likapateknoloji/kicad_libraries/likapa-3dmodels/ESP-WROOM-02.step

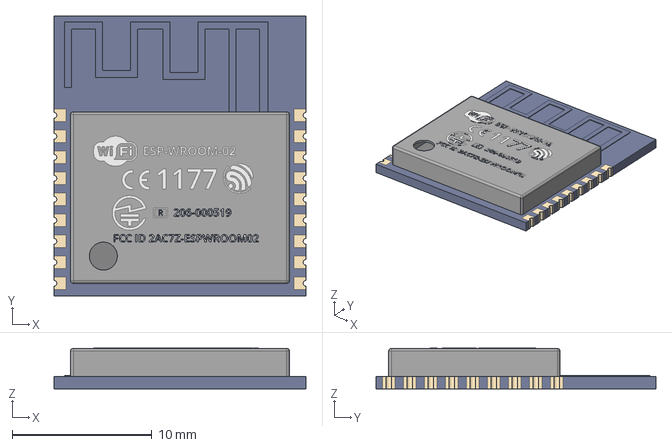
[picture p1: CAD file, 2023-02-28]
likapa-3dmodels/ESP-WROOM-02.step
18.0 x 20.0 x 2.93 mm
