likapateknoloji/kicad_libraries/likapa-3dmodels/TactileButton(6x3,5mm)_SMD.stp

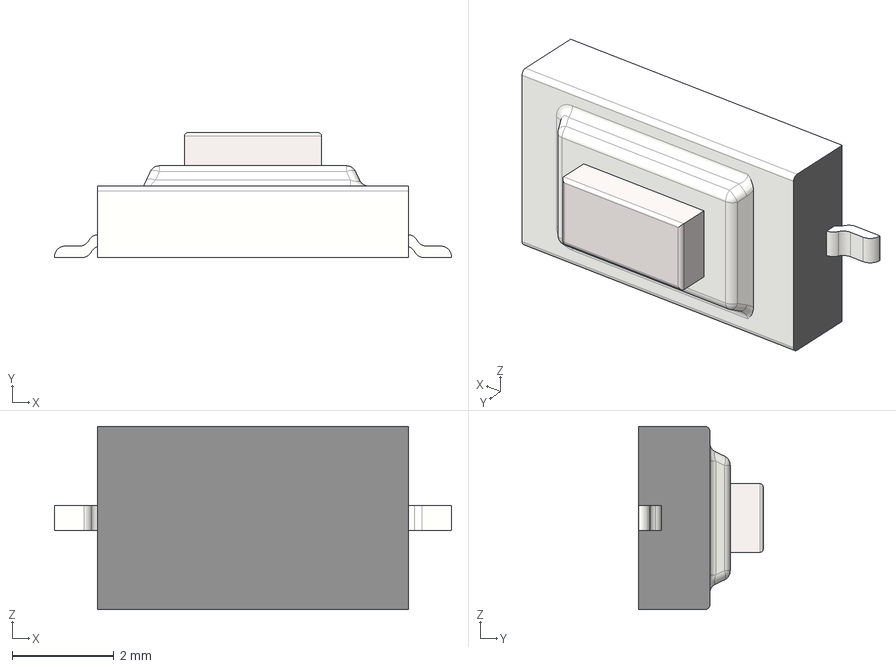
[picture p2: CAD file, 2023-02-28]
likapa-3dmodels/TactileButton(6x3,5mm)_SMD.stp
7.80 x 2.45 x 3.60 mm
