likapateknoloji/kicad_libraries/likapa-3dmodels/ESP32-WROOM-32.step

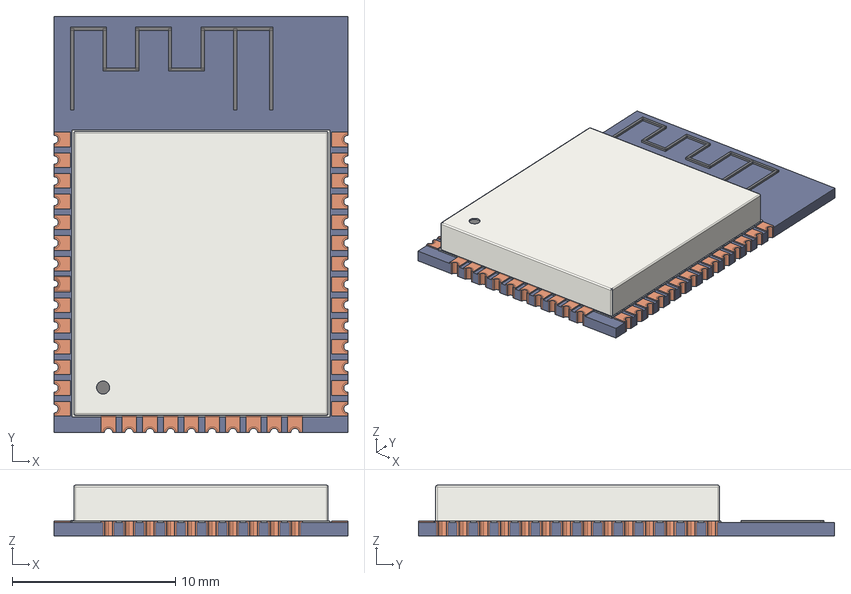
[picture p3: CAD file, 2023-02-28]
likapa-3dmodels/ESP32-WROOM-32.step
18.0 x 25.5 x 3.10 mm
