likapateknoloji/kicad_libraries/likapa-3dmodels/NR3015_inductor.step

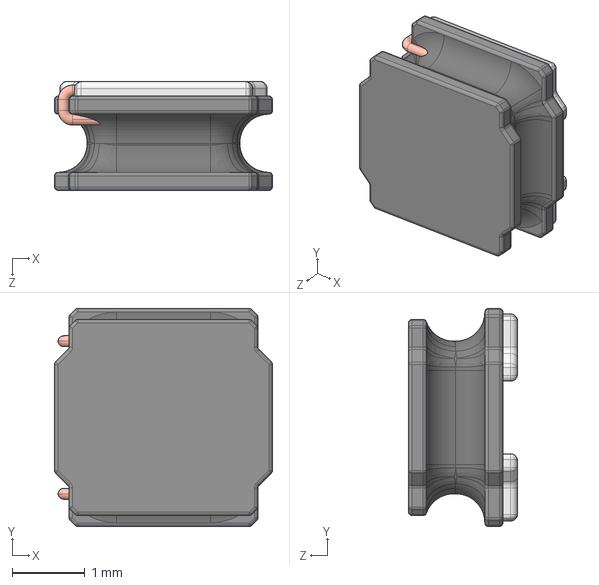
[picture p4: CAD file, 2023-02-28]
likapa-3dmodels/NR3015_inductor.step
3.00 x 3.00 x 1.50 mm
