likapateknoloji/kicad_libraries/likapa-3dmodels/ESP32-WROOM-32U.step

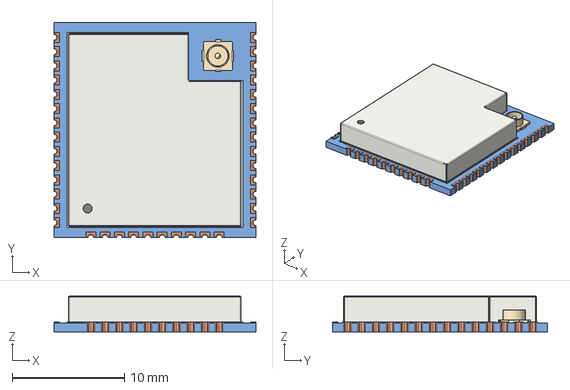
[picture p5: CAD file, 2023-02-28]
likapa-3dmodels/ESP32-WROOM-32U.step
18.0 x 19.2 x 3.20 mm
