likapateknoloji/kicad_libraries/likapa-3dmodels/SARA-R510M8S-00B.stp

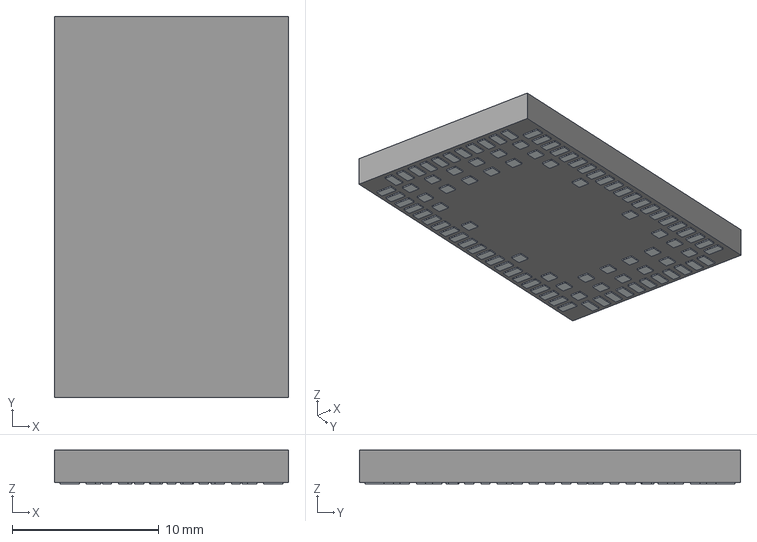
[picture p6: CAD file, 2023-02-28]
likapa-3dmodels/SARA-R510M8S-00B.stp
16.0 x 26.0 x 2.30 mm
Pins
