likapateknoloji/kicad_libraries/likapa-3dmodels/ESP-12E.step

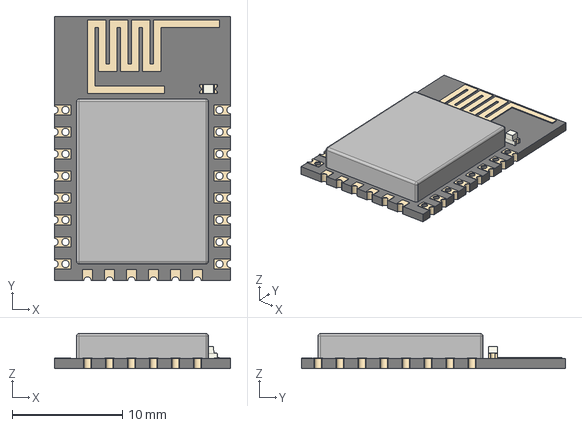
[picture p7: CAD file, 2023-02-28]
likapa-3dmodels/ESP-12E.step
16.0 x 24.0 x 3.20 mm
