likapateknoloji/kicad_libraries/likapa-3dmodels/c-1-2199230-6-b2-3d.stp

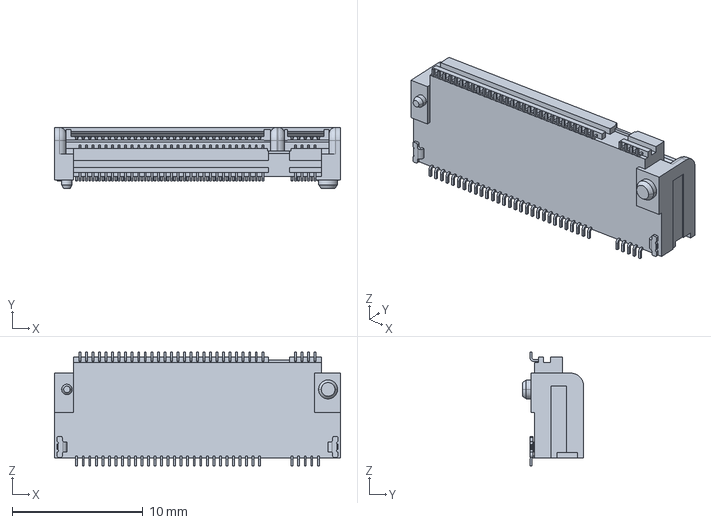
[picture p8: CAD file, 2023-02-28]
likapa-3dmodels/c-1-2199230-6-b2-3d.stp
21.9 x 4.70 x 8.70 mm
