likapateknoloji/kicad_libraries/likapa-3dmodels/NR3030_inductor.STEP

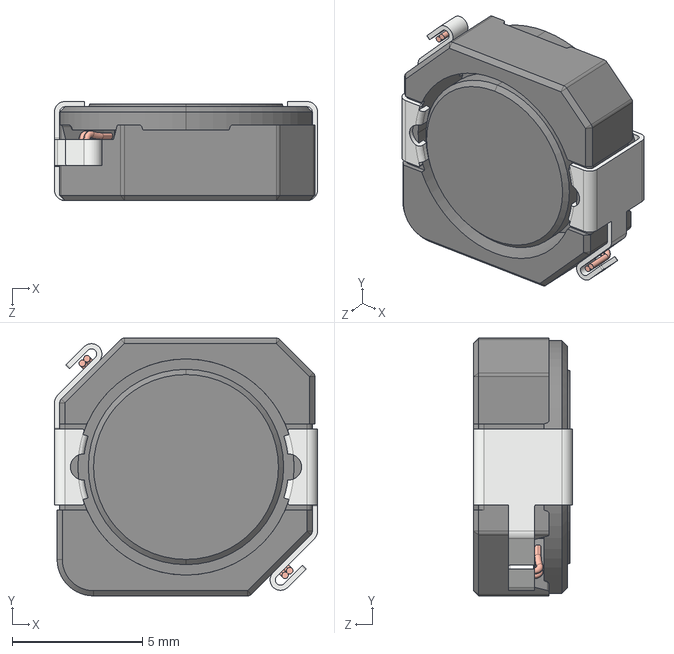
[picture p9: CAD file, 2023-02-28]
likapa-3dmodels/NR3030_inductor.STEP
10.1 x 9.90 x 3.80 mm
