likapateknoloji/kicad_libraries/likapa-3dmodels/c-2129320-3-b-3d.stp

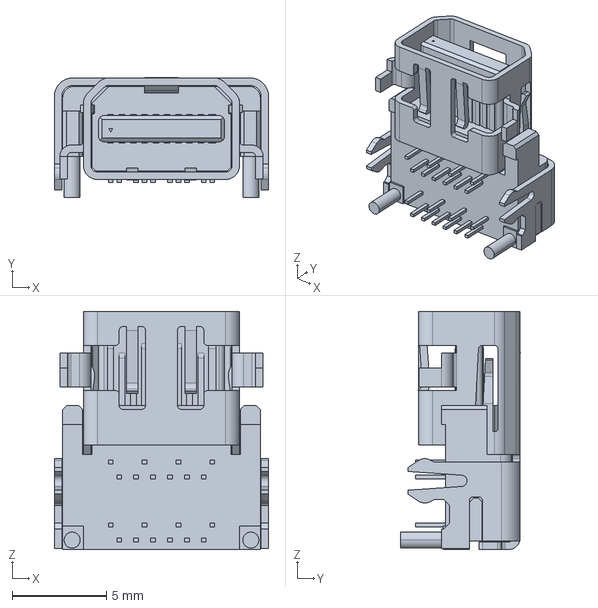
[picture p10: CAD file, 2023-02-28]
likapa-3dmodels/c-2129320-3-b-3d.stp
11.4 x 6.40 x 12.7 mm
