likapateknoloji/kicad_libraries/likapa-3dmodels/Würth 629105150521 Micro USB Connector Right Amgle Receptacle.step

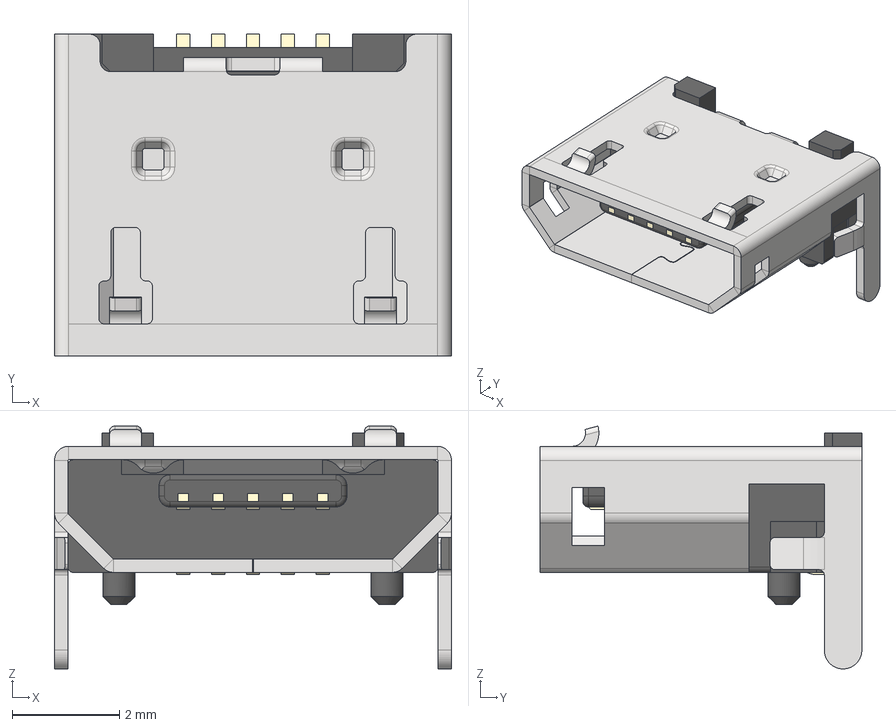
[picture p11: CAD file, 2023-02-28]
likapa-3dmodels/Würth 629105150521 Micro USB Connector Right Amgle Receptacle.step
7.40 x 6.00 x 4.53 mm
Würth 629105150521 Micro USB (Housing)
Würth 629105150521 Micro USB (Inner Shield)
Würth 629105150521 Micro USB (Outer Shield)
Würth 629105150521 Micro USB ( Contact 1,2,4,5) x 4
Würth 629105150521 Micro USB ( Contact 3)
