likapateknoloji/kicad_libraries/likapa-3dmodels/HRO  TYPE-C-31-M-12.step

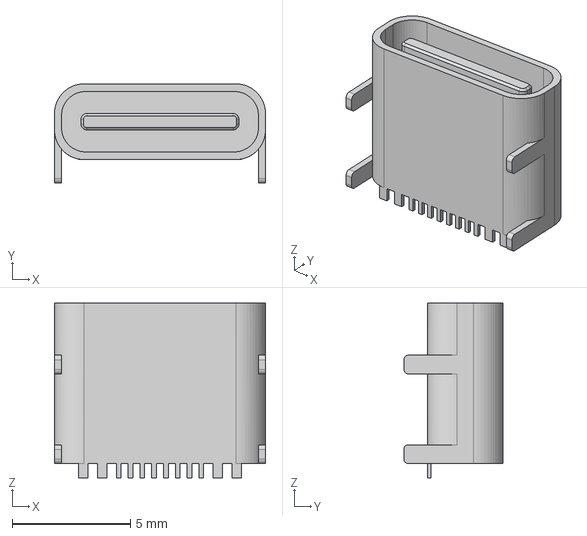
[picture p13: CAD file, 2021-01-02]
likapa-3dmodels/HRO TYPE-C-31-M-12.step
8.94 x 4.21 x 7.40 mm
