likapateknoloji/kicad_libraries/likapa-3dmodels/Tactal Switch - SMD (12mmx12mmx7.5mm).stp

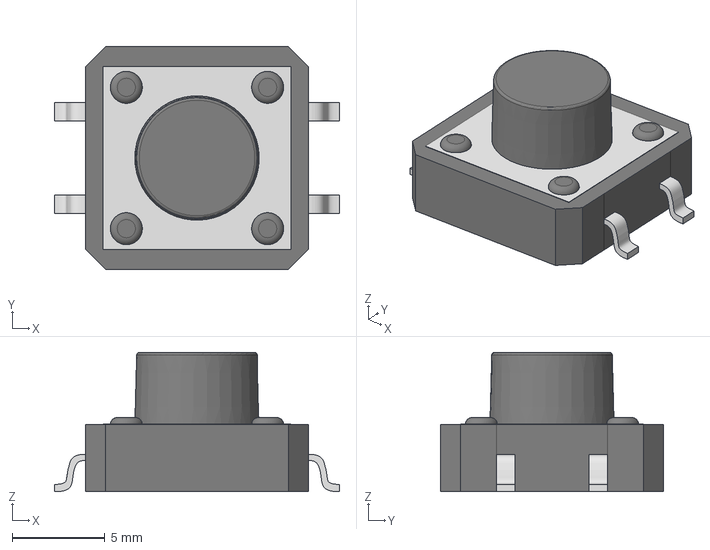
[picture p14: CAD file, 2021-01-02]
likapa-3dmodels/Tactal Switch - SMD (12mmx12mmx7.5mm).stp
15.4 x 12.0 x 7.50 mm
