likapateknoloji/kicad_libraries/likapa-3dmodels/Tactal Switch - SMD (12mmx12mmx6.0mm).stp

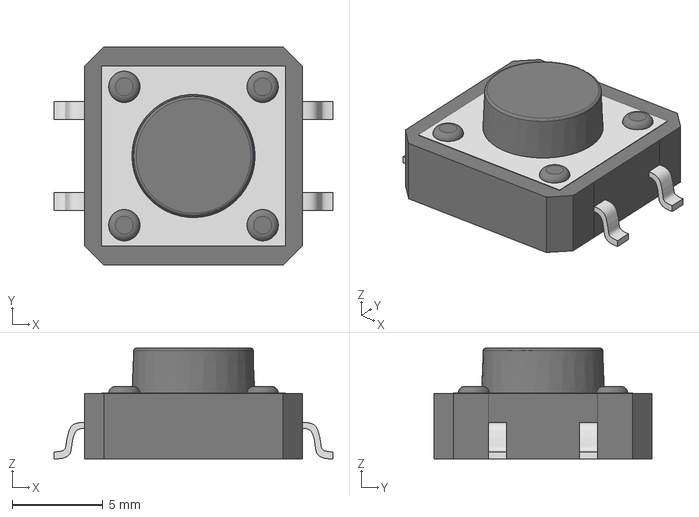
[picture p15: CAD file, 2021-01-02]
likapa-3dmodels/Tactal Switch - SMD (12mmx12mmx6.0mm).stp
15.4 x 12.0 x 6.10 mm
