likapateknoloji/kicad_libraries/likapa-3dmodels/Lipo Charger - TP4056.stp

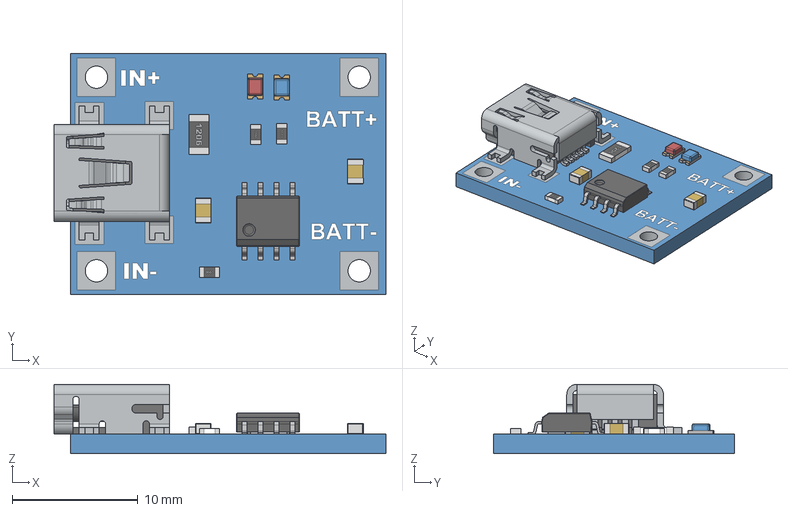
[picture p16: CAD file, 2021-01-02]
likapa-3dmodels/Lipo Charger - TP4056.stp
26.4 x 19.2 x 5.52 mm
bOARD
0603 Resistor x 3
0805 Capacitor x 2
SOIC-8-150
LED - 0805 - Blue
LED - 0805 - Red
User Library-USB_mini_B
1206 Resistor
