likapateknoloji/kicad_libraries/likapa-3dmodels/User Library-MQ303A.STEP

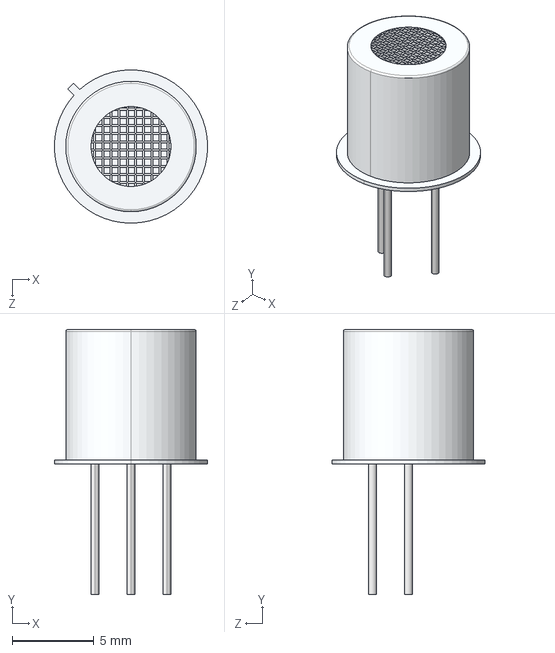
[picture p17: CAD file, 2021-01-02]
likapa-3dmodels/User Library-MQ303A.STEP
9.40 x 16.2 x 9.40 mm
