likapateknoloji/kicad_libraries/likapa-3dmodels/Tactal Switch - SMD (12mmx12mmx9.5mm).stp

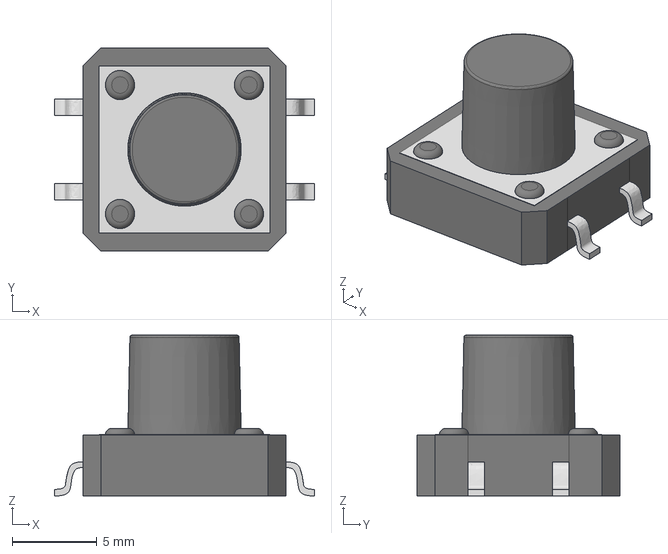
[picture p18: CAD file, 2021-01-02]
likapa-3dmodels/Tactal Switch - SMD (12mmx12mmx9.5mm).stp
15.4 x 12.0 x 9.50 mm
