likapateknoloji/kicad_libraries/likapa-3dmodels/arduinonano.stp

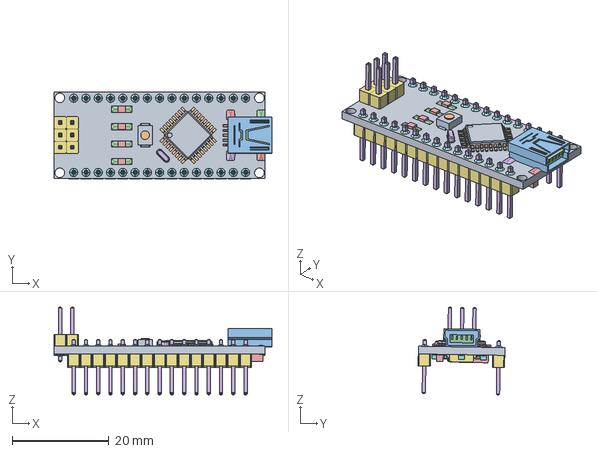
[picture p19: CAD file, 2021-01-02]
likapa-3dmodels/arduinonano.stp
45.1 x 18.0 x 18.2 mm
