likapateknoloji/kicad_libraries/likapa-3dmodels/mics-6814_three_gas_sensor.stp

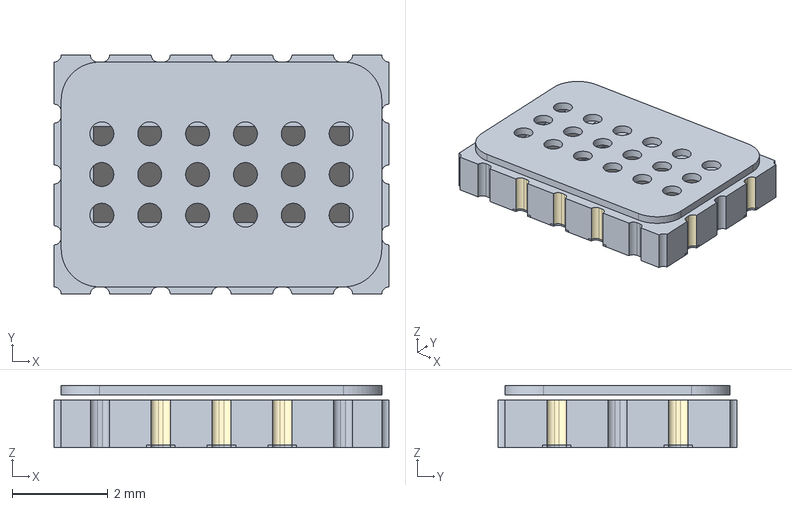
[picture p24: CAD file, 2021-01-02]
likapa-3dmodels/mics-6814_three_gas_sensor.stp
7.00 x 5.00 x 1.30 mm
lid
