likapateknoloji/kicad_libraries/likapa-3dmodels/Tactal Switch - SMD (12mmx12mmx4.3mm).stp

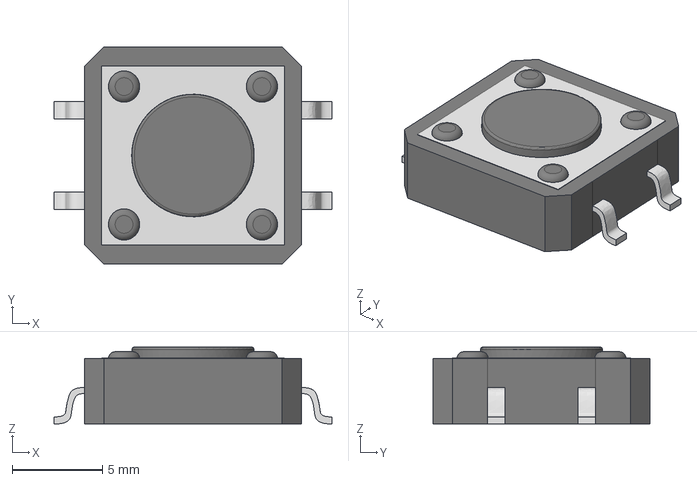
[picture p27: CAD file, 2021-01-02]
likapa-3dmodels/Tactal Switch - SMD (12mmx12mmx4.3mm).stp
15.4 x 12.0 x 4.25 mm
