likapateknoloji/kicad_libraries/likapa-3dmodels/OLED_0.91_avokadio.step

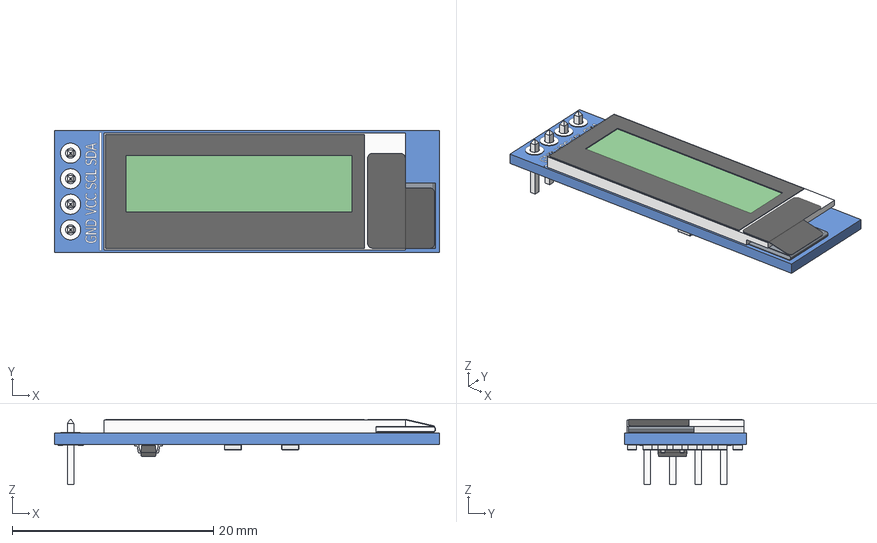
[picture p28: CAD file, 2021-01-02]
likapa-3dmodels/OLED_0.91_avokadio.step
38.3 x 12.1 x 6.51 mm
OLED_0.91_128x32
Pin Header 4 x 1 TH 2.54mm Pitch
RESC-0603 x 13
2SD0601A
