likapateknoloji/kicad_libraries/likapa-3dmodels/0.96 OLED v3.step

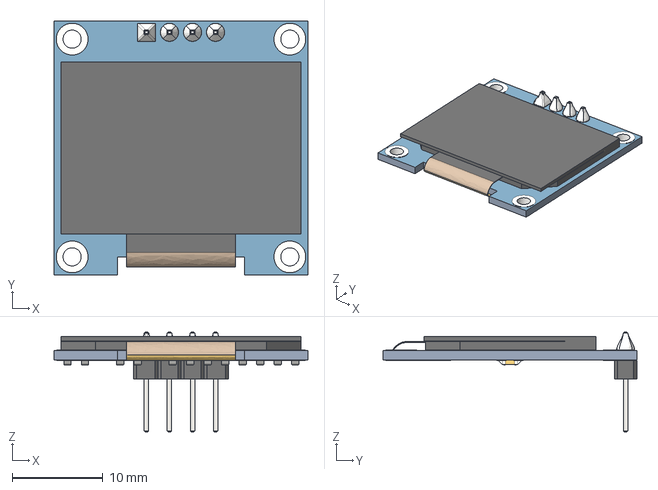
[picture p29: CAD file, 2021-01-02]
likapa-3dmodels/0.96 OLED v3.step
28.0 x 28.0 x 11.0 mm
