likapateknoloji/kicad_libraries/likapa-3dmodels/Tactal Switch - SMD (12mmx12mmx4.5mm).stp

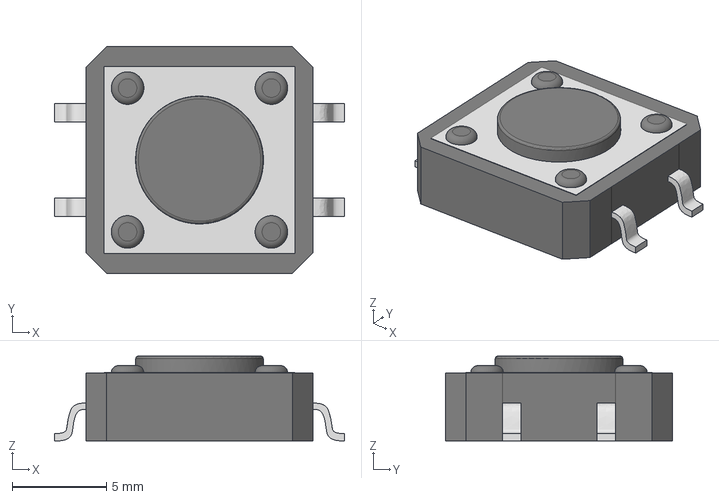
[picture p32: CAD file, 2021-01-02]
likapa-3dmodels/Tactal Switch - SMD (12mmx12mmx4.5mm).stp
15.4 x 12.0 x 4.50 mm
