likapateknoloji/kicad_libraries/(list of files, cad)

Other CAD files:
likapa-3dmodels/146200-0001.stp
likapa-3dmodels/67643-0910.stp
